ATmega8/ICEUP5K/README.md

# ICE40UP5K

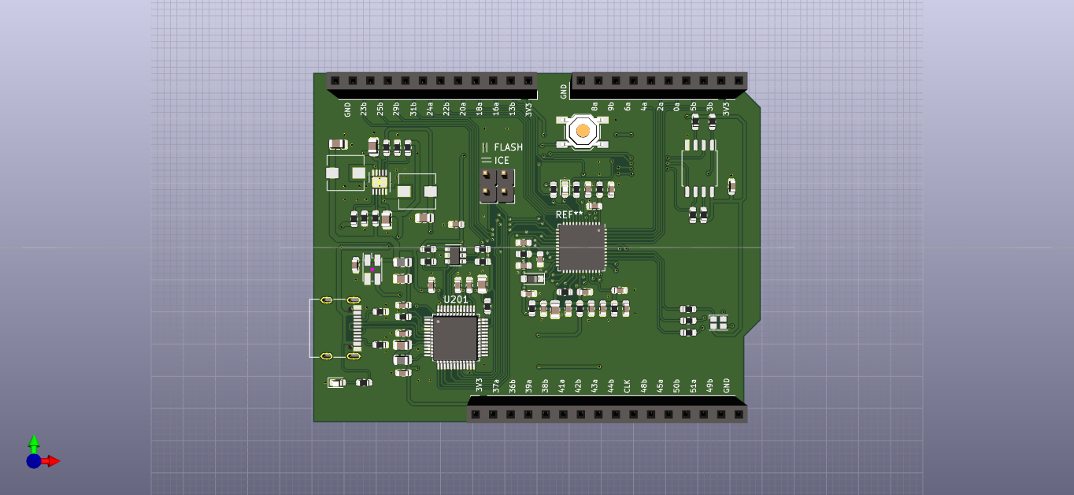
[picture p1: image/ICE40UP5K.png]
3D

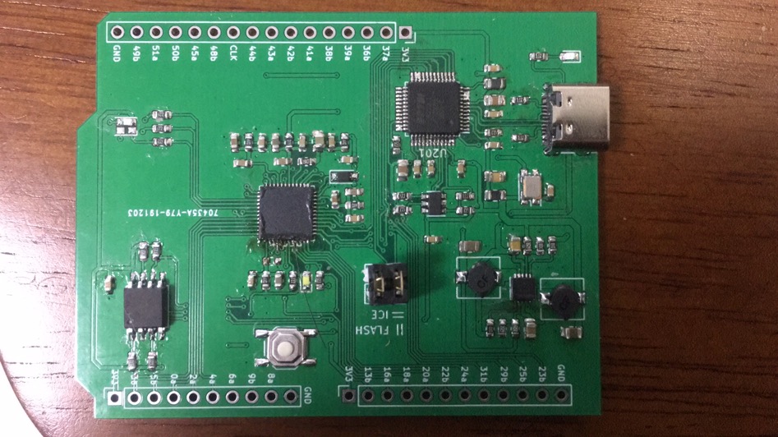
[picture p2: image/1683042906.jpg]
real
