ATmega8/ICEUP5K/ICE40UP5K.kicad_pcb

## KiCad design ICE40UP5K.kicad_pcb (2019-12-08)

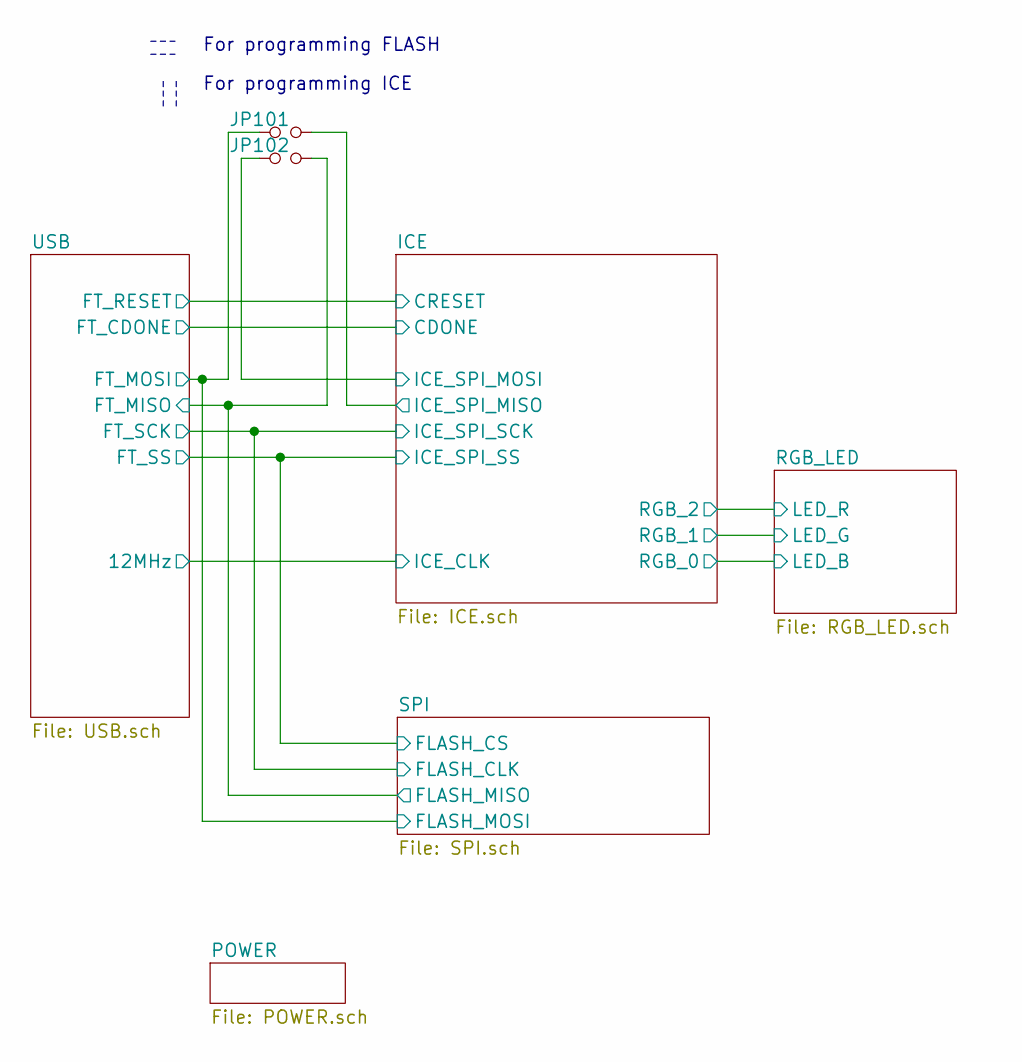
[picture p3: schematic ICE40UP5K.sch]

Parts:
JP101, JP102: Jumper_NO_Small; PinHeader_1x02_P2.54mm_Vertical

Connections:
/ICE/ICE_SPI_MISO: JP101.2; also elsewhere on the board
/ICE/ICE_SPI_MOSI: JP102.1; also elsewhere on the board
/SPI/FLASH_MISO: JP102.2; also elsewhere on the board
/SPI/FLASH_MOSI: JP101.1; also elsewhere on the board

Notes on the sheet:
For programming FLASH
For programming ICE

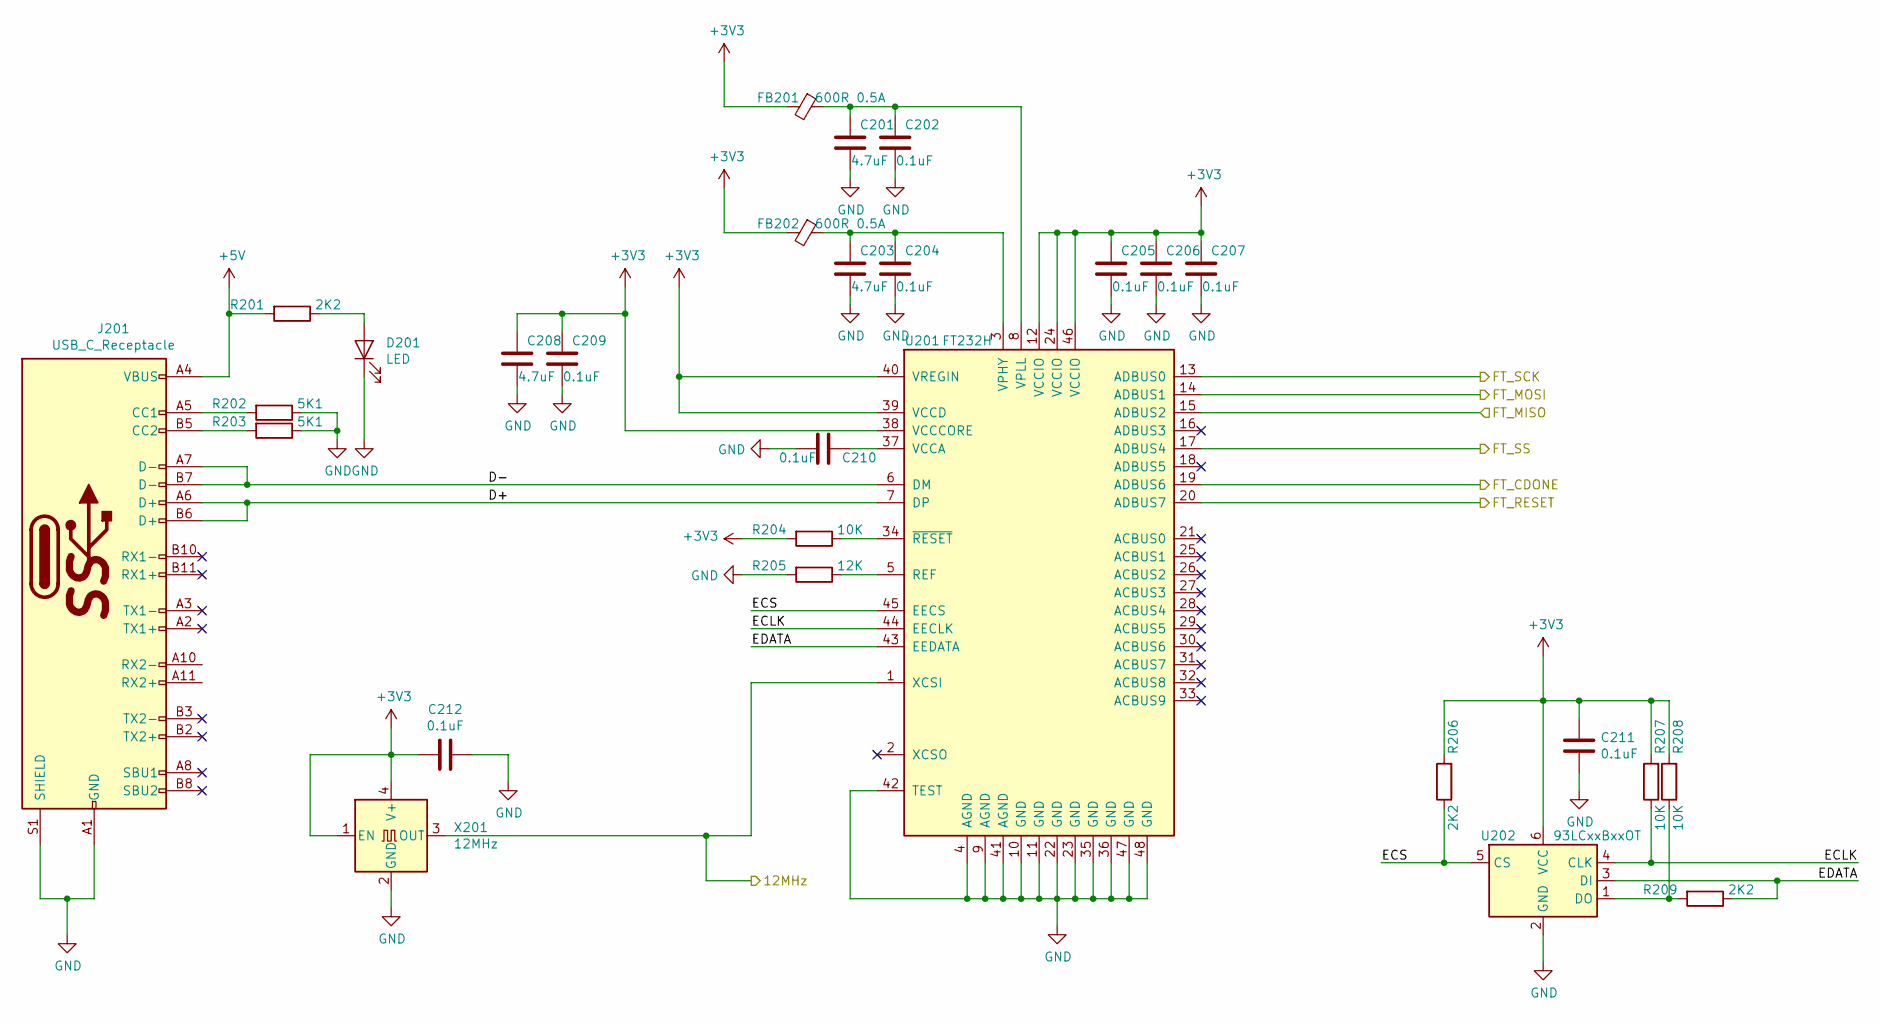
[picture p4: schematic USB.sch]

Parts:
C201, C203, C208: 4.7uF; C_0805_2012Metric
C202, C204, C205, C206, C207, C209, C210, C211, C212: 0.1uF; C_0603_1608Metric
D201: LED; LED_0603_1608Metric
FB201, FB202: 600R 0.5A; L_0805_2012Metric
J201: USB_C_Receptacle; USB_C_Receptacle_Palconn_UTC16-G
R201, R206, R209: 2K2; R_0603_1608Metric
R202, R203: 5K1; R_0603_1608Metric
R204, R207, R208: 10K; R_0603_1608Metric
R205: 12K; R_0603_1608Metric
U201: FT232H; LQFP-48_7x7mm_P0.5mm
U202: 93LCxxBxxOT; SOT-23-6
X201: 12MHz; Oscillator_SMD_EuroQuartz_XO32-4Pin_3.2x2.5mm_HandSoldering

Connections:
+3V3: C205.1, C206.1, C207.1, C208.1, C209.1, C211.1, C212.2, FB201.2, FB202.2, R204.2, R206.2, R207.2, R208.2, U201.12 (VCCIO), U201.24 (VCCIO), U201.38 (VCCCORE), U201.39 (VCCD), U201.40 (VREGIN), U201.46 (VCCIO), U202.6 (VCC), X201.1 (EN), X201.4 (V+); also elsewhere on the board
+5V: J201.A4 (VBUS), J201.A9 (VBUS), J201.B4 (VBUS), J201.B9 (VBUS), R201.2; also elsewhere on the board
/ICE/CDONE: U201.19 (ADBUS6); also elsewhere on the board
/ICE/CRESET: U201.20 (ADBUS7); also elsewhere on the board
/SPI/FLASH_CLK: U201.13 (ADBUS0); also elsewhere on the board
/SPI/FLASH_CS: U201.17 (ADBUS4); also elsewhere on the board
/SPI/FLASH_MISO: U201.15 (ADBUS2); also elsewhere on the board
/SPI/FLASH_MOSI: U201.14 (ADBUS1); also elsewhere on the board
/USB/12MHz: U201.1 (XCSI), X201.3 (OUT); also elsewhere on the board
/USB/D+: J201.A6 (D+), J201.B6 (D+), U201.7 (DP)
/USB/D-: J201.A7 (D-), J201.B7 (D-), U201.6 (DM)
/USB/ECLK: R207.1, U201.44 (EECLK), U202.4 (CLK)
/USB/ECS: R206.1, U201.45 (EECS), U202.5 (CS)
/USB/EDATA: R209.1, U201.43 (EEDATA), U202.3 (DI)
GND: C201.2, C202.2, C203.2, C204.2, C205.2, C206.2, C207.2, C208.2, C209.2, C210.2, C211.2, C212.1, D201.1 (K), J201.A1 (GND), J201.A12 (GND), J201.B1 (GND), J201.B12 (GND), J201.S1 (SHIELD), R202.1, R203.1, R205.2, U201.4 (AGND), U201.9 (AGND), U201.10 (GND), U201.11 (GND), U201.22 (GND), U201.23 (GND), U201.35 (GND), U201.36 (GND), U201.41 (AGND), U201.42 (TEST), U201.47 (GND), U201.48 (GND), U202.2 (GND), X201.2 (GND); also elsewhere on the board
unnamed: C201.1, C202.1, FB201.1, U201.8 (VPLL)
unnamed: C203.1, C204.1, FB202.1, U201.3 (VPHY)
unnamed: C210.1, U201.37 (VCCA)
unnamed: D201.2 (A), R201.1
unnamed: J201.A5 (CC1), R202.2
unnamed: J201.B5 (CC2), R203.2
unnamed: R204.1, U201.34 (~RESET)
unnamed: R205.1, U201.5 (REF)
unnamed: R208.1, R209.2, U202.1 (DO)

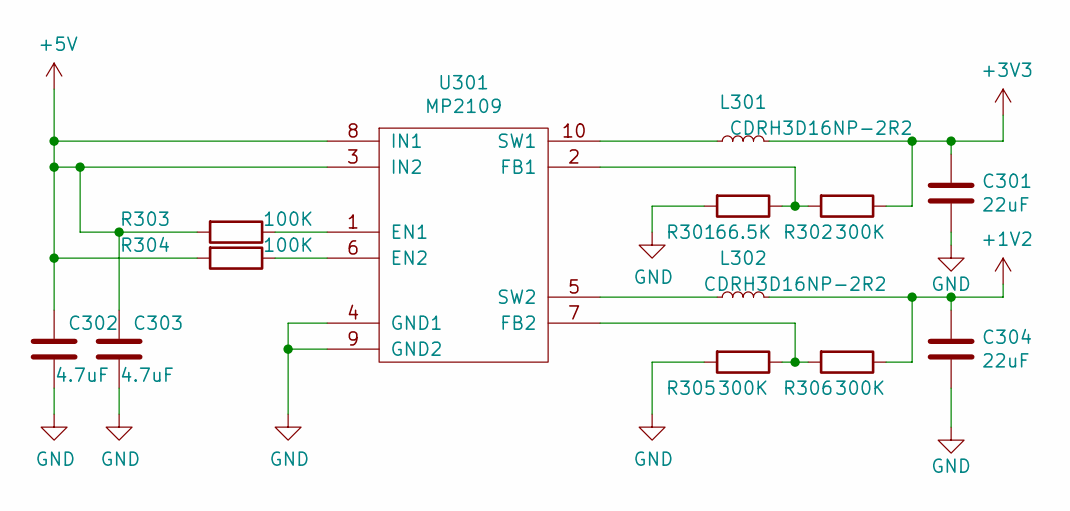
[picture p5: schematic POWER.sch]

Parts:
C301, C304: 22uF; C_0805_2012Metric
C302, C303: 4.7uF; C_0805_2012Metric
L301, L302: CDRH3D16NP-2R2; L_Wuerth_HCI-5040
R301: 66.5K; R_0603_1608Metric
R302, R305, R306: 300K; R_0603_1608Metric
R303, R304: 100K; R_0603_1608Metric
U301: MP2109; DFN-10-1EP_3x3mm_P0.5mm_EP1.65x2.38mm_ThermalVias

Connections:
+1V2: C304.1, L302.2, R306.1; also elsewhere on the board
+3V3: C301.1, L301.2, R302.1; also elsewhere on the board
+5V: C302.1, C303.1, R303.2, R304.2, U301.3 (IN2), U301.8 (IN1); also elsewhere on the board
GND: C301.2, C302.2, C303.2, C304.2, R301.2, R305.2, U301.4 (GND1), U301.9 (GND2); also elsewhere on the board
unnamed: L301.1, U301.10 (SW1)
unnamed: L302.1, U301.5 (SW2)
unnamed: R301.1, R302.2, U301.2 (FB1)
unnamed: R303.1, U301.1 (EN1)
unnamed: R304.1, U301.6 (EN2)
unnamed: R305.1, R306.2, U301.7 (FB2)

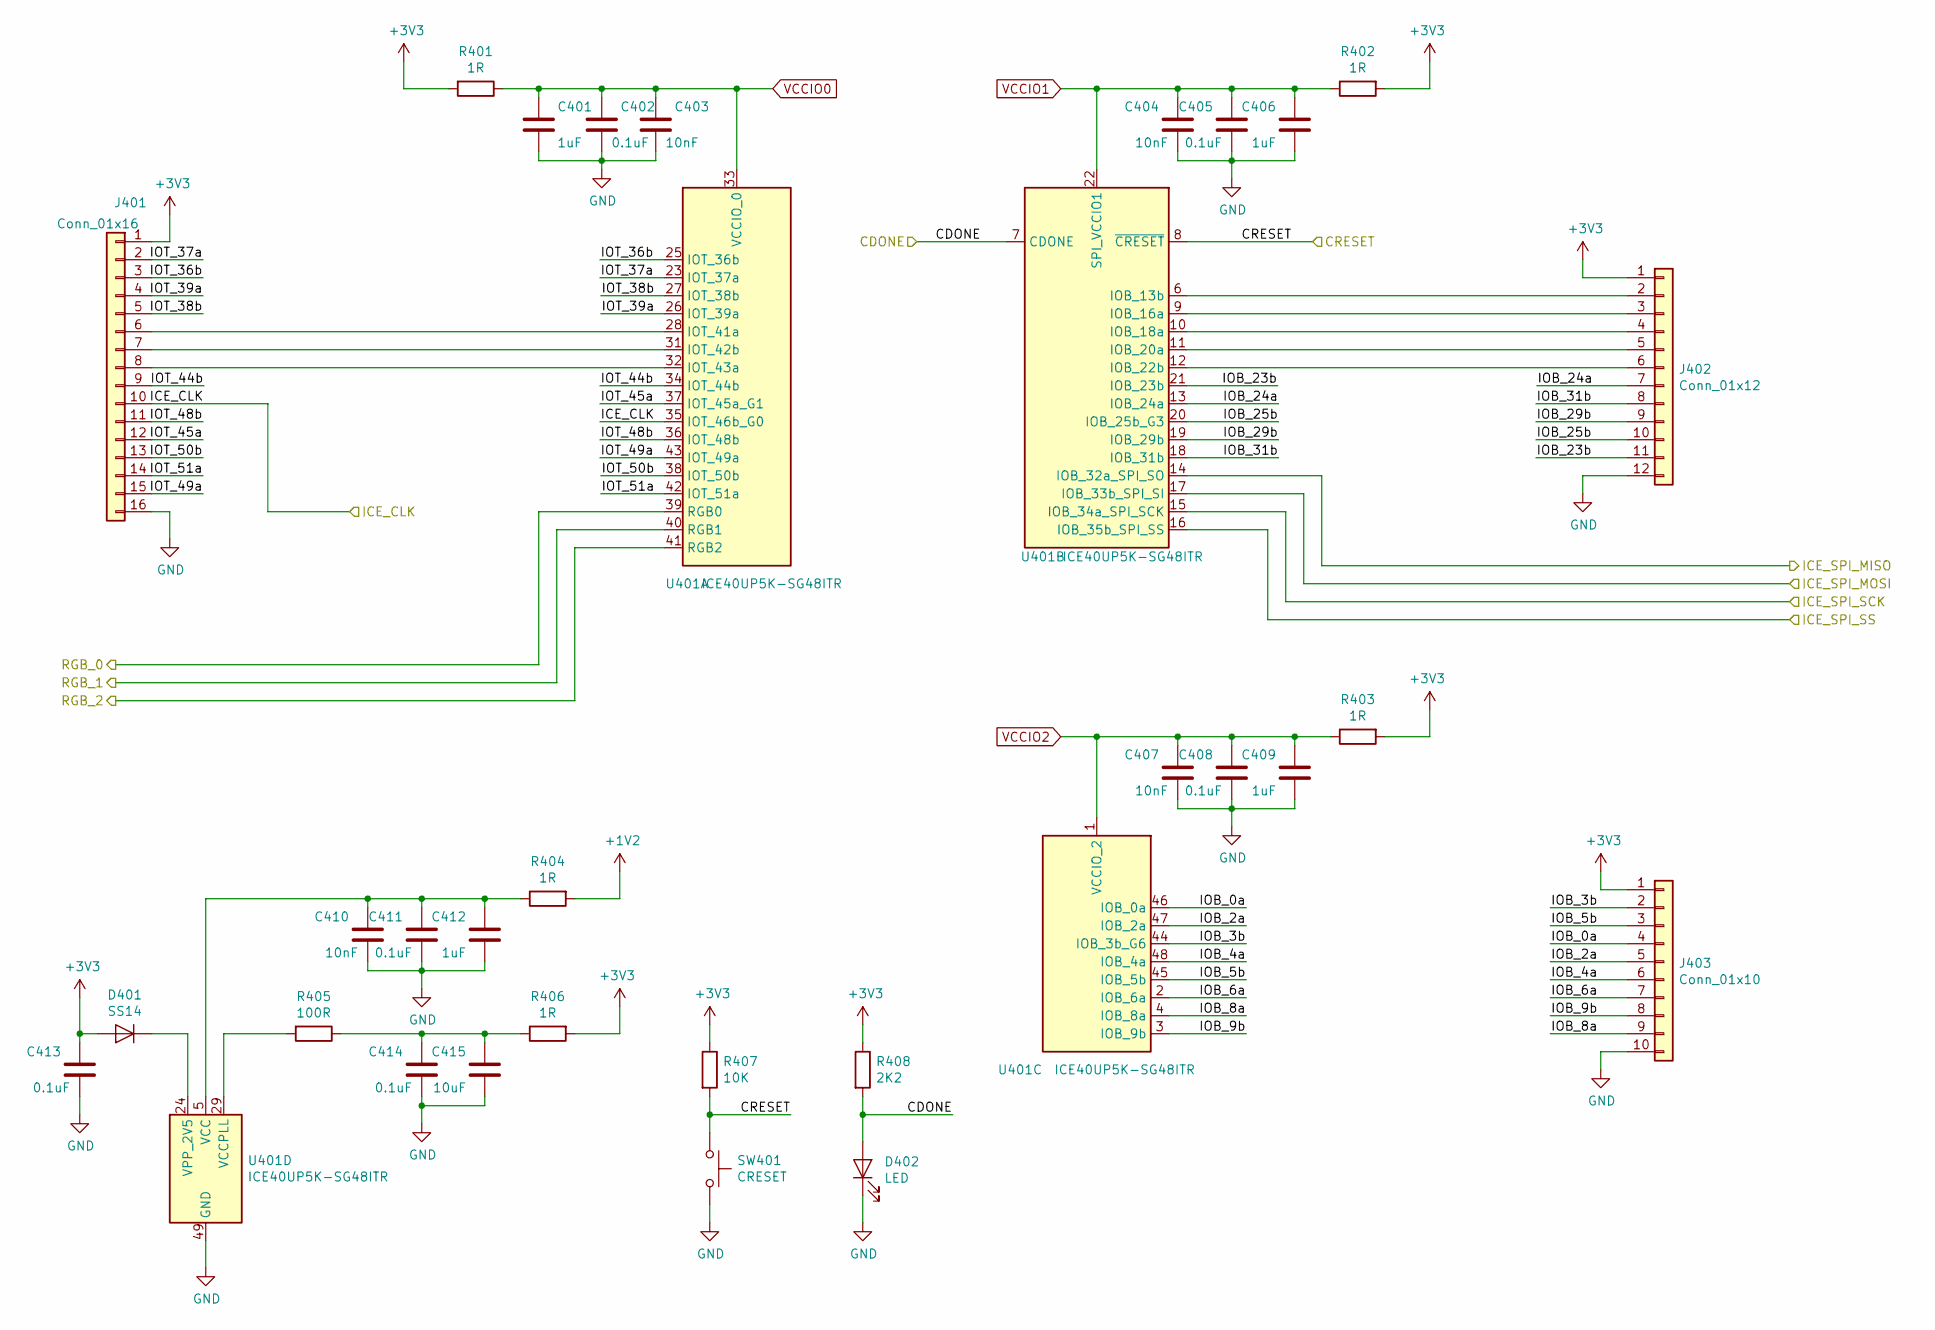
[picture p6: schematic ICE.sch]

Parts:
C401, C406, C409, C412: 1uF; C_0603_1608Metric
C402, C405, C408, C411, C413, C414: 0.1uF; C_0603_1608Metric
C403, C404, C407, C410: 10nF; C_0603_1608Metric
C415: 10uF; C_0805_2012Metric
D401: SS14; D_SOD-323_HandSoldering
D402: LED; LED_0603_1608Metric
J401: Conn_01x16; PinSocket_1x16_P2.54mm_Vertical
J402: Conn_01x12; PinSocket_1x12_P2.54mm_Vertical
J403: Conn_01x10; PinSocket_1x10_P2.54mm_Vertical
R401, R402, R403, R404, R406: 1R; R_0603_1608Metric
R405: 100R; R_0603_1608Metric
R407: 10K; R_0603_1608Metric
R408: 2K2; R_0603_1608Metric
SW401: CRESET; SW_SPST_TL3342
U401: ICE40UP5K-SG48ITR; QFN-48-1EP_7x7mm_P0.5mm_EP5.6x5.6mm

Connections:
+1V2: R404.2; also elsewhere on the board
+3V3: C413.1, D401.2 (A), J401.1, J402.1, J403.1, R401.2, R402.2, R403.2, R406.2, R407.1, R408.1; also elsewhere on the board
/ICE/CDONE: D402.2 (A), R408.2, U401.7 (CDONE); also elsewhere on the board
/ICE/CRESET: R407.2, SW401.1, U401.8 (~CRESET); also elsewhere on the board
/ICE/ICE_SPI_MISO: U401.14 (IOB_32a_SPI_SO); also elsewhere on the board
/ICE/ICE_SPI_MOSI: U401.17 (IOB_33b_SPI_SI); also elsewhere on the board
/ICE/IOB_0a: J403.4, U401.46 (IOB_0a)
/ICE/IOB_2a: J403.5, U401.47 (IOB_2a)
/ICE/IOB_3b: J403.2, U401.44 (IOB_3b_G6)
/ICE/IOB_4a: J403.6, U401.48 (IOB_4a)
/ICE/IOB_5b: J403.3, U401.45 (IOB_5b)
/ICE/IOB_6a: J403.7, U401.2 (IOB_6a)
/ICE/IOB_8a: J403.9, U401.4 (IOB_8a)
/ICE/IOB_9b: J403.8, U401.3 (IOB_9b)
/ICE/IOB_23b: J402.11, U401.21 (IOB_23b)
/ICE/IOB_24a: J402.7, U401.13 (IOB_24a)
/ICE/IOB_25b: J402.10, U401.20 (IOB_25b_G3)
/ICE/IOB_29b: J402.9, U401.19 (IOB_29b)
/ICE/IOB_31b: J402.8, U401.18 (IOB_31b)
/ICE/IOT_36b: J401.3, U401.25 (IOT_36b)
/ICE/IOT_37a: J401.2, U401.23 (IOT_37a)
/ICE/IOT_38b: J401.5, U401.27 (IOT_38b)
/ICE/IOT_39a: J401.4, U401.26 (IOT_39a)
/ICE/IOT_44b: J401.9, U401.34 (IOT_44b)
/ICE/IOT_45a: J401.12, U401.37 (IOT_45a_G1)
/ICE/IOT_48b: J401.11, U401.36 (IOT_48b)
/ICE/IOT_49a: J401.15, U401.43 (IOT_49a)
/ICE/IOT_50b: J401.13, U401.38 (IOT_50b)
/ICE/IOT_51a: J401.14, U401.42 (IOT_51a)
/RGB_LED/LED_B: U401.39 (RGB0); also elsewhere on the board
/RGB_LED/LED_G: U401.40 (RGB1); also elsewhere on the board
/RGB_LED/LED_R: U401.41 (RGB2); also elsewhere on the board
/SPI/FLASH_CLK: U401.15 (IOB_34a_SPI_SCK); also elsewhere on the board
/SPI/FLASH_CS: U401.16 (IOB_35b_SPI_SS); also elsewhere on the board
/USB/12MHz: J401.10, U401.35 (IOT_46b_G0); also elsewhere on the board
GND: C401.2, C402.2, C403.2, C404.2, C405.2, C406.2, C407.2, C408.2, C409.2, C410.2, C411.2, C412.2, C413.2, C414.2, C415.2, D402.1 (K), J401.16, J402.12, J403.10, SW401.2, U401.49 (GND); also elsewhere on the board
unnamed: C410.1, C411.1, C412.1, R404.1, U401.5 (VCC), U401.30 (VCC)
unnamed: C414.1, C415.1, R405.1, R406.1
unnamed: D401.1 (K), U401.24 (VPP_2V5)
unnamed: J401.6, U401.28 (IOT_41a)
unnamed: J401.7, U401.31 (IOT_42b)
unnamed: J401.8, U401.32 (IOT_43a)
unnamed: J402.2, U401.6 (IOB_13b)
unnamed: J402.3, U401.9 (IOB_16a)
unnamed: J402.4, U401.10 (IOB_18a)
unnamed: J402.5, U401.11 (IOB_20a)
unnamed: J402.6, U401.12 (IOB_22b)
unnamed: R405.2, U401.29 (VCCPLL)
VCCIO0: C401.1, C402.1, C403.1, R401.1, U401.33 (VCCIO_0)
VCCIO1: C404.1, C405.1, C406.1, R402.1, U401.22 (SPI_VCCIO1)
VCCIO2: C407.1, C408.1, C409.1, R403.1, U401.1 (VCCIO_2)

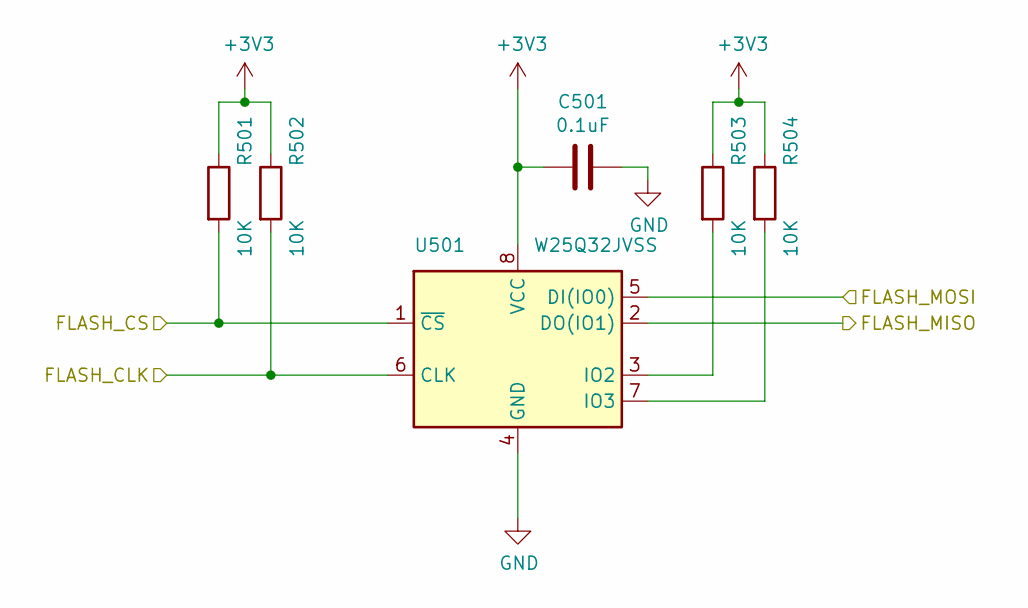
[picture p7: schematic SPI.sch]

Parts:
C501: 0.1uF; C_0603_1608Metric
R501, R502, R503, R504: 10K; R_0603_1608Metric
U501: W25Q32JVSS; SOIC-8_5.23x5.23mm_P1.27mm

Connections:
+3V3: C501.1, R501.1, R502.1, R503.1, R504.1, U501.8 (VCC); also elsewhere on the board
/SPI/FLASH_CLK: R502.2, U501.6 (CLK); also elsewhere on the board
/SPI/FLASH_CS: R501.2, U501.1 (~CS); also elsewhere on the board
/SPI/FLASH_MISO: U501.2 (DO(IO1)); also elsewhere on the board
/SPI/FLASH_MOSI: U501.5 (DI(IO0)); also elsewhere on the board
GND: C501.2, U501.4 (GND); also elsewhere on the board
unnamed: R503.2, U501.3 (IO2)
unnamed: R504.2, U501.7 (IO3)

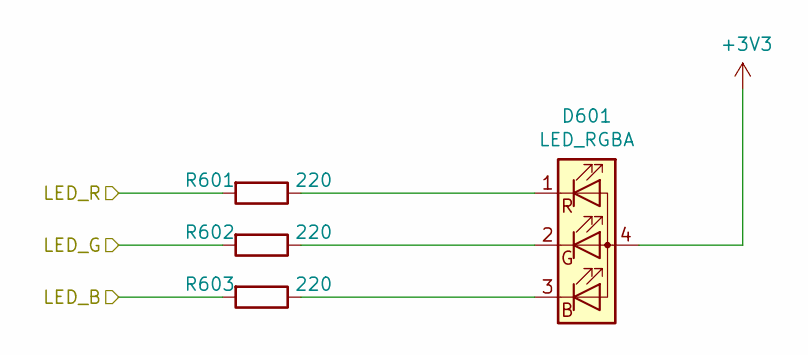
[picture p8: schematic RGB_LED.sch]

Parts:
D601: LED_RGBA; LED_Cree-PLCC4_2x2mm_CW
R601, R602, R603: 220; R_0603_1608Metric

Connections:
+3V3: D601.4 (A); also elsewhere on the board
/RGB_LED/LED_B: R603.2; also elsewhere on the board
/RGB_LED/LED_G: R602.2; also elsewhere on the board
/RGB_LED/LED_R: R601.2; also elsewhere on the board
unnamed: D601.1 (RK), R601.1
unnamed: D601.2 (GK), R602.1
unnamed: D601.3 (BK), R603.1

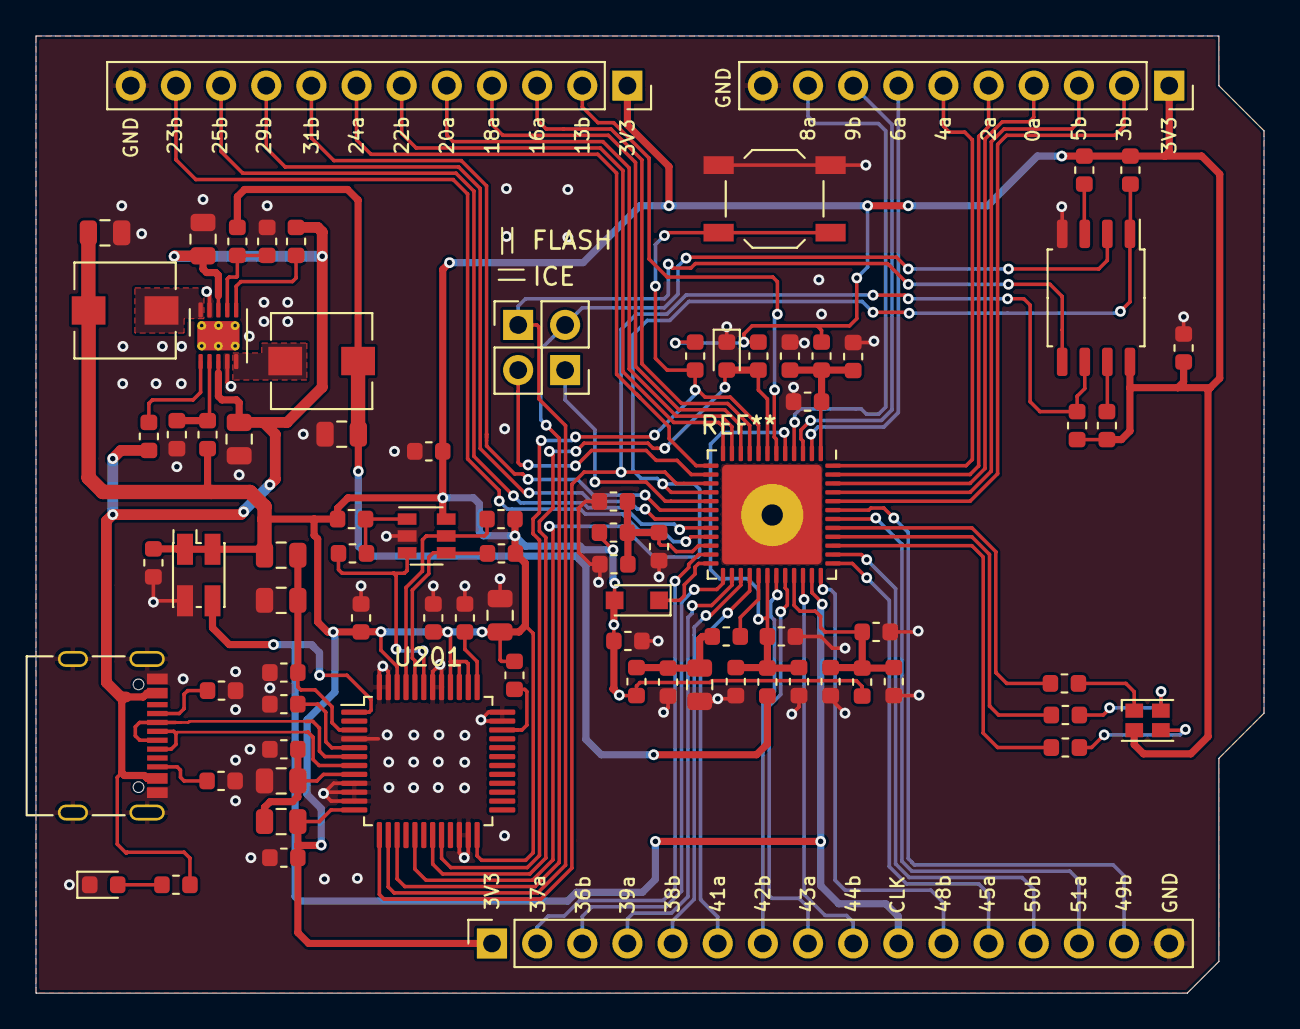
[picture p9: board ICE40UP5K.kicad_pcb from above]

Board: 2 copper layers, 69.1 x 53.8 mm, 82 parts (0 on the bottom side), 79 nets.
